nightmechanic/WRFL/power_switch.png

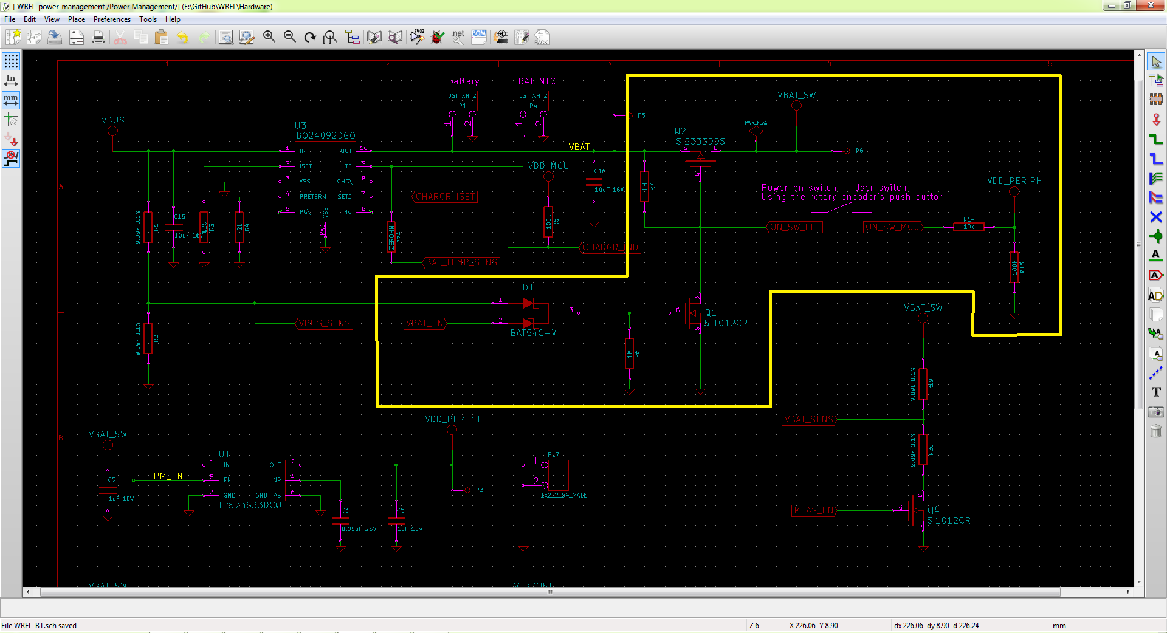
power_switch.png
