nightmechanic/WRFL/Hardware/WRFL_BT.sch

## KiCad design Hardware/WRFL_BT.sch (2014-01-19)

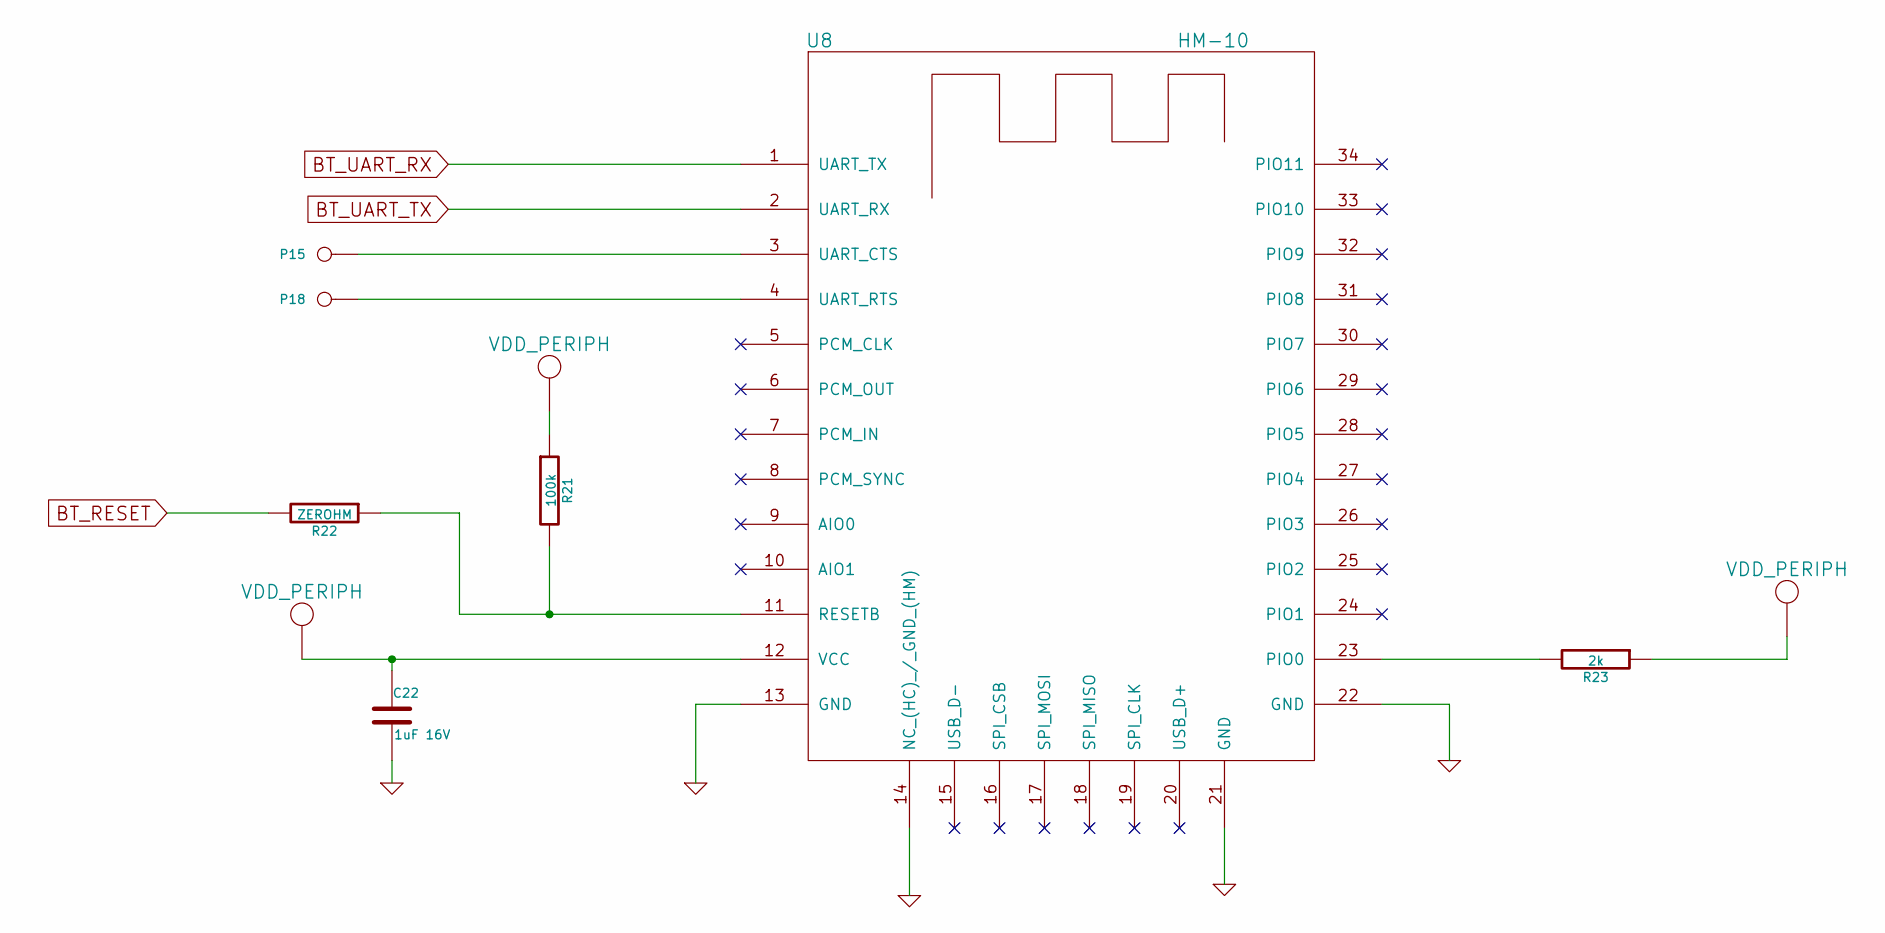
[picture p2: schematic WRFL_BT.sch]

Parts:
C22: 1uF 16V; 0805
P15, P18: TEST_POINT
R21: 100k; 0805
R22: ZEROHM; 0805
R23: 2k; 0805
U8: HM-10

Connections:
BT_RESET: R22.2
BT_UART_RX: U8.1 (UART_TX)
BT_UART_TX: U8.2 (UART_RX)
GND: C22.2, U8.13 (GND), U8.14 (NC_(HC)_/_GND_(HM)), U8.21 (GND), U8.22 (GND)
unnamed: P15.1, U8.3 (UART_CTS)
unnamed: P18.1, U8.4 (UART_RTS)
unnamed: R21.2, R22.1, U8.11 (RESETB)
unnamed: R23.2, U8.23 (PIO0)
VDD_PERIPH: C22.1, R21.1, R23.1, U8.12 (VCC)
