nightmechanic/WRFL/Hardware/WRFL_Launchpad.sch

## KiCad design Hardware/WRFL_Launchpad.sch (2014-01-19)

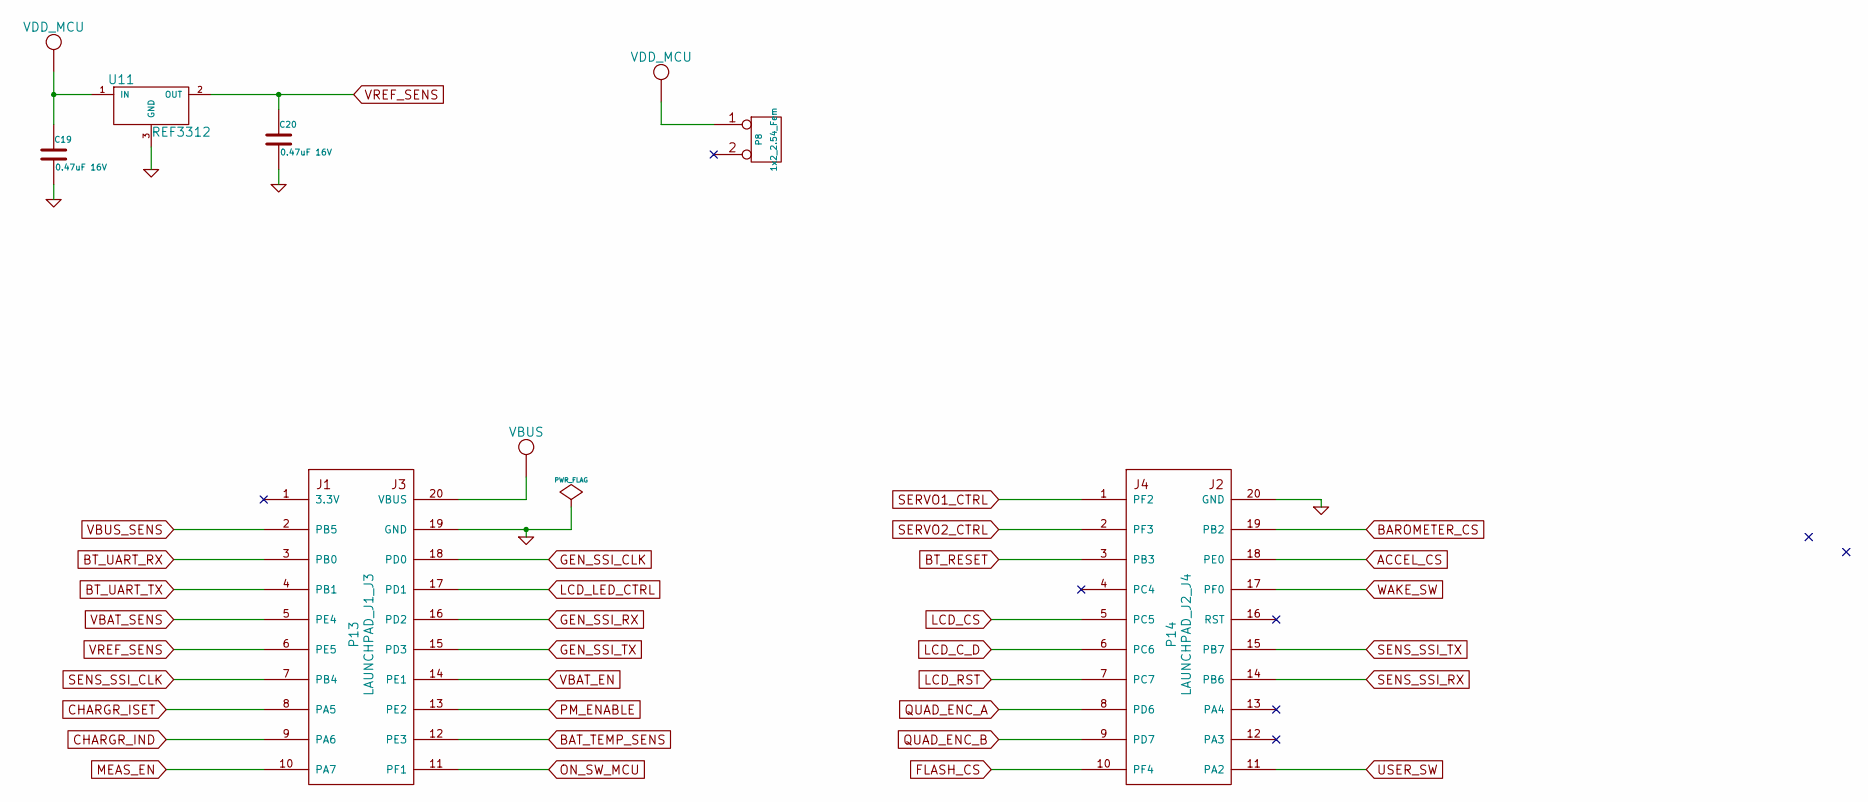
[picture p3: schematic WRFL_Launchpad.sch]

Parts:
C19, C20: 0.47uF 16V; 0805
P8: 1x2_2.54_Fem
P13: LAUNCHPAD_J1_J3
P14: LAUNCHPAD_J2_J4
U11: REF3312

Connections:
ACCEL_CS: P14.18 (PE0)
BAROMETER_CS: P14.19 (PB2)
BAT_TEMP_SENS: P13.12 (PE3)
BT_RESET: P14.3 (PB3)
BT_UART_RX: P13.3 (PB0)
BT_UART_TX: P13.4 (PB1)
CHARGR_IND: P13.9 (PA6)
CHARGR_ISET: P13.8 (PA5)
FLASH_CS: P14.10 (PF4)
GEN_SSI_CLK: P13.18 (PD0)
GEN_SSI_RX: P13.16 (PD2)
GEN_SSI_TX: P13.15 (PD3)
GND: C19.2, C20.2, P13.19 (GND), P14.20 (GND), U11.3 (GND)
LCD_CS: P14.5 (PC5)
LCD_C_D: P14.6 (PC6)
LCD_LED_CTRL: P13.17 (PD1)
LCD_RST: P14.7 (PC7)
MEAS_EN: P13.10 (PA7)
ON_SW_MCU: P13.11 (PF1)
PM_ENABLE: P13.13 (PE2)
QUAD_ENC_A: P14.8 (PD6)
QUAD_ENC_B: P14.9 (PD7)
SENS_SSI_CLK: P13.7 (PB4)
SENS_SSI_RX: P14.14 (PB6)
SENS_SSI_TX: P14.15 (PB7)
SERVO1_CTRL: P14.1 (PF2)
SERVO2_CTRL: P14.2 (PF3)
USER_SW: P14.11 (PA2)
VBAT_EN: P13.14 (PE1)
VBAT_SENS: P13.5 (PE4)
VBUS: P13.20 (VBUS)
VBUS_SENS: P13.2 (PB5)
VDD_MCU: C19.1, P8.1, U11.1 (IN)
VREF_SENS: C20.1, P13.6 (PE5), U11.2 (OUT)
WAKE_SW: P14.17 (PF0)
