nightmechanic/WRFL/Hardware/WRFL_Sensors.sch

## KiCad design Hardware/WRFL_Sensors.sch (2014-01-19)

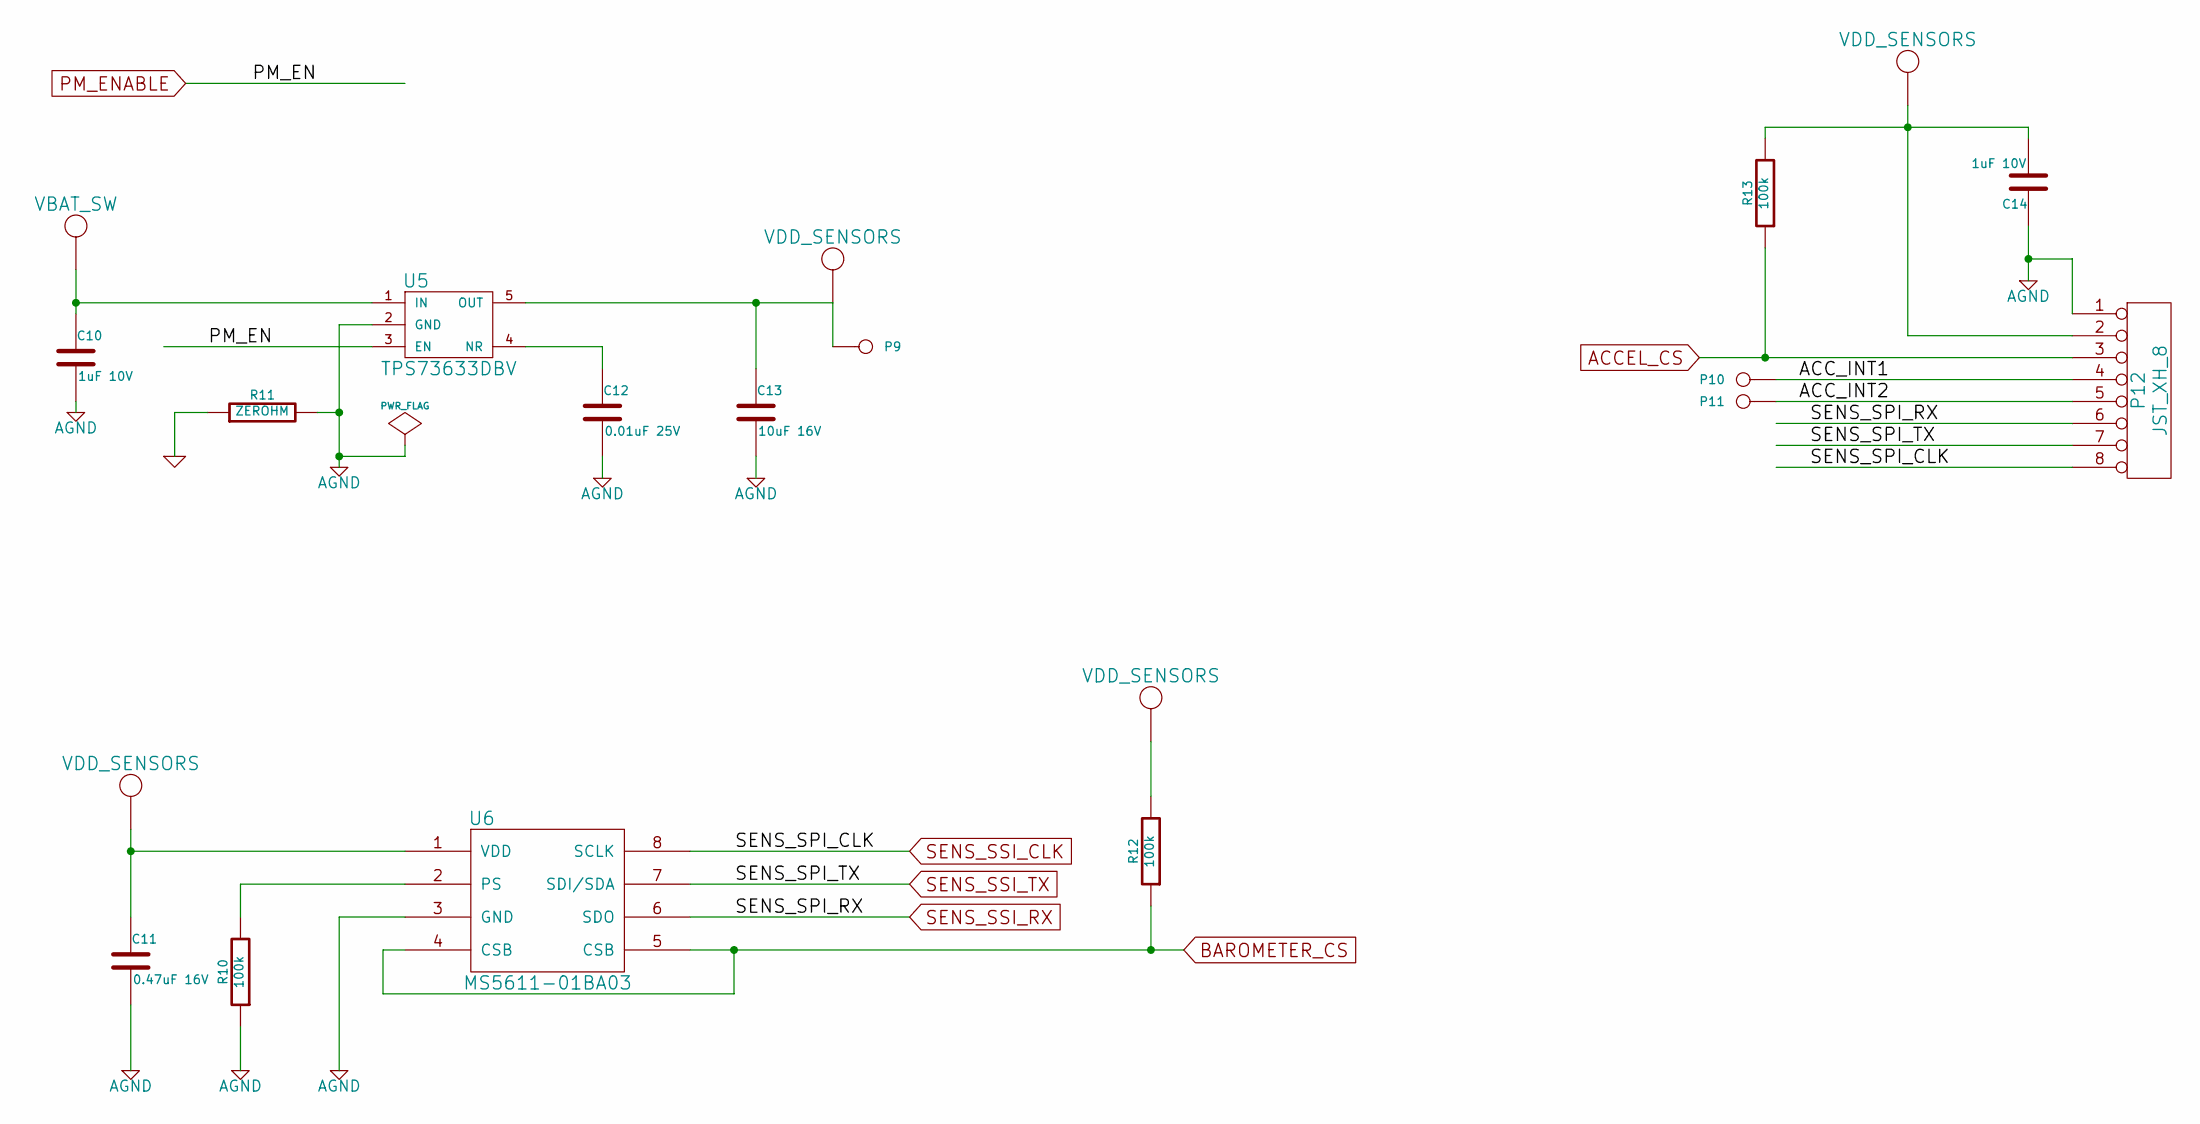
[picture p4: schematic WRFL_Sensors.sch]

Parts:
C10, C14: 1uF 10V; 0805
C11: 0.47uF 16V; 0805
C12: 0.01uF 25V; 0805
C13: 10uF 16V; 0805
P9, P10, P11: TEST_POINT
P12: JST_XH_8
R10, R12, R13: 100k; 0805
R11: ZEROHM; 0805
U5: TPS73633DBV
U6: MS5611-01BA03

Connections:
ACCEL_CS: P12.3, R13.1
ACC_INT1: P10.1, P12.4
ACC_INT2: P11.1, P12.5
AGND: C10.2, C11.2, C12.2, C13.2, C14.1, P12.1, R10.1, R11.2, U5.2 (GND), U6.3 (GND)
BAROMETER_CS: R12.1, U6.4 (CSB), U6.5 (CSB)
GND: R11.1
unnamed: C12.1, U5.4 (NR)
unnamed: R10.2, U6.2 (PS)
PM_ENABLE: U5.3 (EN)
SENS_SSI_CLK: P12.8, U6.8 (SCLK)
SENS_SSI_RX: P12.6, U6.6 (SDO)
SENS_SSI_TX: P12.7, U6.7 (SDI/SDA)
VBAT_SW: C10.1, U5.1 (IN)
VDD_SENSORS: C11.1, C13.1, C14.2, P9.1, P12.2, R12.2, R13.2, U5.5 (OUT), U6.1 (VDD)
