nightmechanic/WRFL/Hardware/WRFL_User_Interface.sch

## KiCad design Hardware/WRFL_User_Interface.sch (2014-01-19)

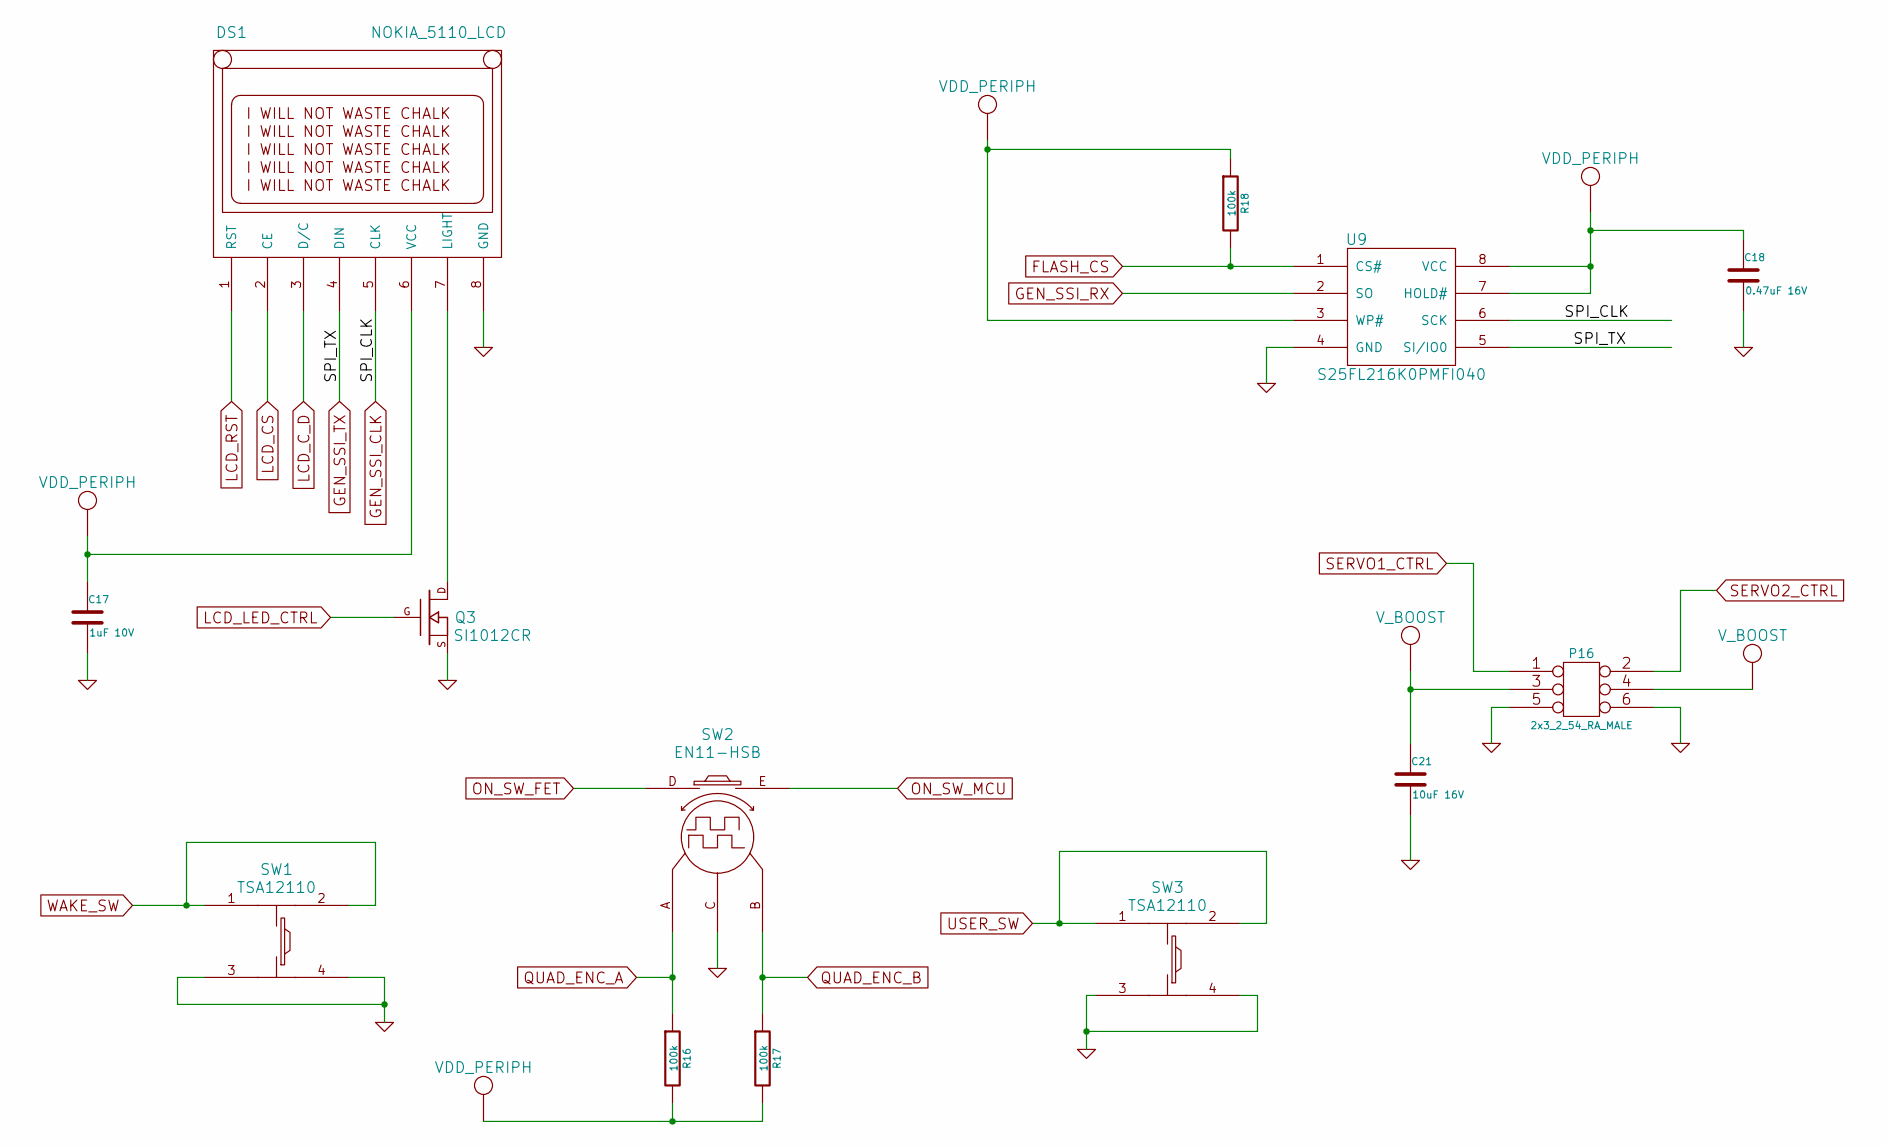
[picture p5: schematic WRFL_User_Interface.sch]

Parts:
C17: 1uF 10V; 0805
C18: 0.47uF 16V; 0805
C21: 10uF 16V; 0805
DS1: NOKIA_5110_LCD
P16: 2x3_2_54_RA_MALE
Q3: SI1012CR; SC-75A
R16, R17, R18: 100k; 0805
SW1, SW3: TSA12110
SW2: EN11-HSB
U9: S25FL216K0PMFI040

Connections:
FLASH_CS: R18.2, U9.1 (CS#)
GEN_SSI_CLK: DS1.5 (CLK), U9.6 (SCK)
GEN_SSI_RX: U9.2 (SO)
GEN_SSI_TX: DS1.4 (DIN), U9.5 (SI/IO0)
GND: C17.2, C18.2, C21.2, DS1.8 (GND), P16.5, P16.6, Q3.S, SW1.3, SW1.4, SW2.C, SW3.3, SW3.4, U9.4 (GND)
LCD_CS: DS1.2 (CE)
LCD_C_D: DS1.3 (D/C)
LCD_LED_CTRL: Q3.G
LCD_RST: DS1.1 (RST)
unnamed: DS1.7 (LIGHT), Q3.D
ON_SW_FET: SW2.D
ON_SW_MCU: SW2.E
QUAD_ENC_A: R16.1, SW2.A
QUAD_ENC_B: R17.1, SW2.B
SERVO1_CTRL: P16.1
SERVO2_CTRL: P16.2
USER_SW: SW3.1, SW3.2
VDD_PERIPH: C17.1, C18.1, DS1.6 (VCC), R16.2, R17.2, R18.1, U9.3 (WP#), U9.7 (HOLD#), U9.8 (VCC)
V_BOOST: C21.1, P16.3, P16.4
WAKE_SW: SW1.1, SW1.2
