nightmechanic/WRFL/Hardware/WRFL_power_management.sch

## KiCad design Hardware/WRFL_power_management.sch (2014-01-19)

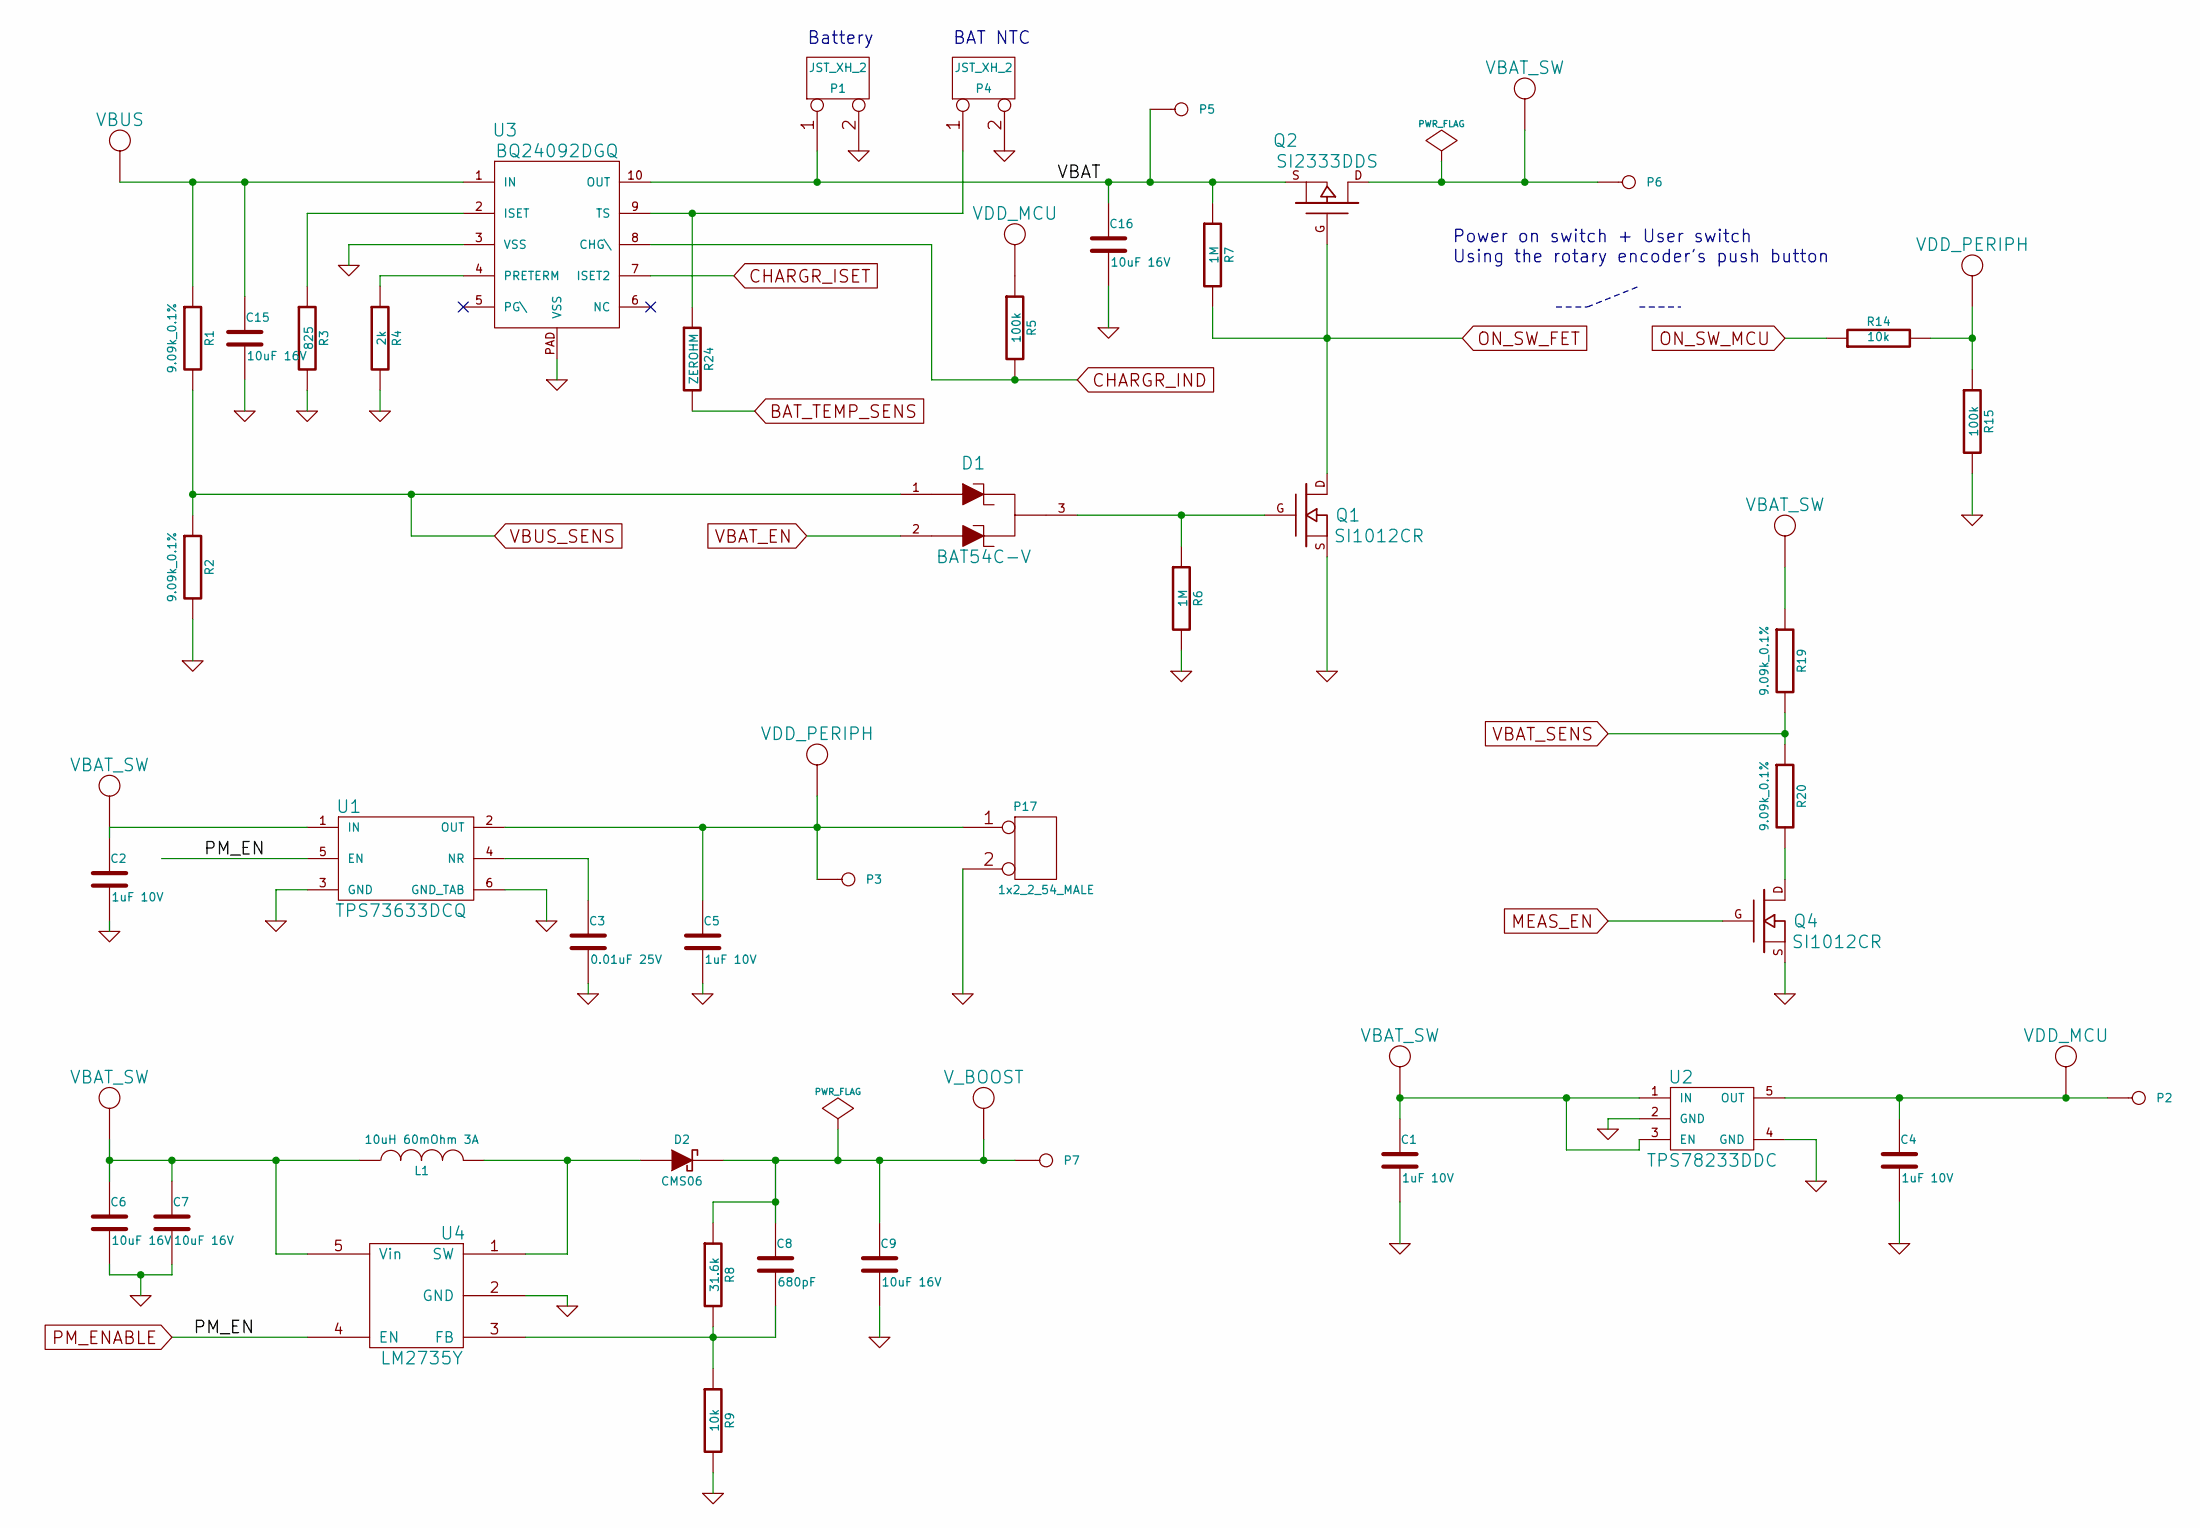
[picture p6: schematic WRFL_power_management.sch]

Parts:
C1, C2, C4, C5: 1uF 10V; 0805
C3: 0.01uF 25V; 0805
C6, C7, C9, C15, C16: 10uF 16V; 0805
C8: 680pF; 0805
D1: BAT54C-V; SOT-23
D2: CMS06
L1: 10uH 60mOhm 3A
P1, P4: JST_XH_2
P2, P3, P5, P6, P7: TEST_POINT
P17: 1x2_2_54_MALE
Q1, Q4: SI1012CR; SC-75A
Q2: SI2333DDS; SOT-23
R1, R2, R19, R20: 9.09k_0.1%; 0805
R3: 825; 0805
R4: 2k; 0805
R5, R15: 100k; 0805
R6, R7: 1M; 0805
R8: 31.6k; 0805
R9, R14: 10k; 0805
R24: ZEROHM; 0805
U1: TPS73633DCQ
U2: TPS78233DDC
U3: BQ24092DGQ
U4: LM2735Y

Connections:
BAT_TEMP_SENS: R24.2
CHARGR_IND: R5.2, U3.8 (CHG\)
CHARGR_ISET: U3.7 (ISET2)
GND: C1.2, C2.2, C3.2, C4.2, C5.2, C6.2, C7.2, C9.2, C15.2, C16.2, P1.2 (PM), P4.2 (PM), P17.2 (PM), Q1.S, Q4.S, R2.2, R3.2, R4.2, R6.2, R9.2, R15.2, U1.3 (GND), U1.6 (GND_TAB), U2.2 (GND), U2.4 (GND), U3.3 (VSS), U3.PAD (VSS), U4.2 (GND)
MEAS_EN: Q4.G
unnamed: C3.1, U1.4 (NR)
unnamed: C8.2, R8.2, R9.1, U4.3 (FB)
unnamed: D1.3 (K), Q1.G, R6.1
unnamed: D2.1 (A), L1.2, U4.1 (SW)
unnamed: P4.1, R24.1, U3.9 (TS)
unnamed: Q4.D, R20.2
unnamed: R3.1, U3.2 (ISET)
unnamed: R4.1, U3.4 (PRETERM)
ON_SW_FET: Q1.D, Q2.G, R7.2
ON_SW_MCU: R14.1
PM_ENABLE: U1.5 (EN), U4.4 (EN)
VBAT: C16.1, P1.1, P5.1, Q2.S, R7.1, U3.10 (OUT)
VBAT_EN: D1.2 (A2)
VBAT_SENS: R19.2, R20.1
VBAT_SW: C1.1, C2.1, C6.1, C7.1, L1.1, P6.1, Q2.D, R19.1, U1.1 (IN), U2.1 (IN), U2.3 (EN), U4.5 (Vin)
VBUS: C15.1, R1.1, U3.1 (IN)
VBUS_SENS: D1.1 (A1), R1.2, R2.1
VDD_MCU: C4.1, P2.1, R5.1, U2.5 (OUT)
VDD_PERIPH: C5.1, P3.1, P17.1, R14.2, R15.1, U1.2 (OUT)
V_BOOST: C8.1, C9.1, D2.2 (K), P7.1, R8.1

Notes on the sheet:
Power on switch + User switch Using the rotary encoder's push button
Battery
BAT NTC
