nightmechanic/WRFL/Firmware/WRFL_Proto/Nokia5110.c

// Nokia5110.c
// Runs on LM4F120
// Use SSI0 to send an 8-bit code to the Nokia5110 48x84
// pixel LCD to display text, images, or other information.
// Daniel Valvano
// June 17, 2013

// Font table, initialization, and other functions based
// off of Nokia_5110_Example from Spark Fun:
// 7-17-2011
// Spark Fun Electronics 2011
// Nathan Seidle
// http://dlnmh9ip6v2uc.cloudfront.net/datasheets/LCD/Monochrome/Nokia_5110_Example.pde

/* This example accompanies the book
   "Embedded Systems: Real Time Interfacing to Arm Cortex M Microcontrollers",
   ISBN: 978-1463590154, Jonathan Valvano, copyright (c) 2013

 Copyright 2013 by Jonathan W. Valvano, valvano@mail.utexas.edu
    You may use, edit, run or distribute this file
    as long as the above copyright notice remains
 THIS SOFTWARE IS PROVIDED "AS IS".  NO WARRANTIES, WHETHER EXPRESS, IMPLIED
 OR STATUTORY, INCLUDING, BUT NOT LIMITED TO, IMPLIED WARRANTIES OF
 MERCHANTABILITY AND FITNESS FOR A PARTICULAR PURPOSE APPLY TO THIS SOFTWARE.
 VALVANO SHALL NOT, IN ANY CIRCUMSTANCES, BE LIABLE FOR SPECIAL, INCIDENTAL,
 OR CONSEQUENTIAL DAMAGES, FOR ANY REASON WHATSOEVER.
 For more information about my classes, my research, and my books, see
 http://users.ece.utexas.edu/~valvano/
 */

/* Modified by Ran Katz (Nightmechanic) for the WRFL project
 * modified to use standard TI Tivaware peripheral drivers (in ROM if available)
 */

// Signal        (Nokia 5110) LM4F120 pin
// Reset         (RST, pin 1) connected to PA7
// SSI0Fss       (CE,  pin 2) connected to PA3
// Data/Command  (DC,  pin 3) connected to PA6
// SSI0Tx        (Din, pin 4) connected to PA5
// SSI0Clk       (Clk, pin 5) connected to PA2
// 3.3V          (Vcc, pin 6) power
// not connected (BL,  pin 7) back light
// Ground        (Gnd, pin 8)


#include "Nokia5110.h"
#include "platform.h"

#include <stdbool.h>
#include <stdint.h>

#include "inc/hw_types.h"
#include "driverlib/ssi.h"
#include "driverlib/gpio.h"
#include "driverlib/sysctl.h"
#include "driverlib/rom.h"
#include "driverlib/rom_map.h"

#define RESET(value)			(GPIOPinWrite(LCD_RESET_PORT, LCD_RESET_PIN,  value))
#define RESET_LOW               0
#define RESET_HIGH              LCD_RESET_PIN
#define DC(value)				(GPIOPinWrite(LCD_DC_PORT, LCD_DC_PIN, value))
#define DC_COMMAND              0
#define DC_DATA                 LCD_DC_PIN
#define DC_VALUE				(GPIOPinRead(LCD_DC_PORT, LCD_DC_PIN))


enum typeOfWrite{
  COMMAND,                              // the transmission is an LCD command
  DATA                                  // the transmission is data
};
// This is a helper function that sends an 8-bit message to the LCD.
// inputs: type  COMMAND or DATA
//         data  8-bit data to transmit
// outputs: none
// assumes: SSI0 and port A have already been initialized
static void lcdwrite(enum typeOfWrite type, char data){
	//unsigned int dummy;
	int new_DC;


	if(type == COMMAND){
		new_DC=DC_COMMAND;
	} else{
		new_DC=DC_DATA;
	}

	//check if the DC line needs to change - if so we must do that after the
	if (new_DC != DC_VALUE){
		//wait for SPI to finish
		while(MAP_SSIBusy(LCD_SSI_BASE));
	}

	DC(new_DC);

  MAP_SSIDataPut(LCD_SSI_BASE, data);


}

//********Nokia5110_Init*****************
// Initialize Nokia 5110 48x84 LCD by sending the proper
// commands to the PCD8544 driver.  One new feature of the
// LM4F120 is that its SSIs can get their baud clock from
// either the system clock or from the 16 MHz precision
// internal oscillator.  If the system clock is faster than
// 50 MHz, the SSI baud clock will be faster than the 4 MHz
// maximum of the Nokia 5110.
// inputs: none
// outputs: none
// assumes: system clock rate of 50 MHz or less
void Nokia5110_Init(void){
  volatile unsigned long delay;


  //disable SSI
  MAP_SSIDisable(LCD_SSI_BASE);
  //set clock and other parameters
  MAP_SSIConfigSetExpClk(LCD_SSI_BASE, SysCtlClockGet(), SSI_FRF_MOTO_MODE_0,
                         SSI_MODE_MASTER, 3000000, 8);
  //enable SSI
  MAP_SSIEnable(LCD_SSI_BASE);

  RESET(RESET_LOW);                    // reset the LCD to a known state
  for(delay=0; delay<10; delay=delay+1);// delay minimum 100 ns
  RESET(RESET_HIGH);                   // negative logic

  lcdwrite(COMMAND, 0x21);              // chip active; horizontal addressing mode (V = 0); use extended instruction set (H = 1)
  lcdwrite(COMMAND, 0xb8);              // set LCD Vop (contrast): try 0xB1 (good @ 3.3V) or 0xBF if your display is too dark
  lcdwrite(COMMAND, 0x04);              // set temp coefficient
  lcdwrite(COMMAND, 0x14);              // LCD bias mode 1:48: try 0x13 or 0x14

  lcdwrite(COMMAND, 0x20);              // we must send 0x20 before modifying the display control mode
  lcdwrite(COMMAND, 0x0c);              // set display control to normal mode: 0x0D for inverse
}

//********Nokia5110_OutChar*****************
// Print a character to the Nokia 5110 48x84 LCD.  The
// character will be printed at the current cursor position,
// the cursor will automatically be updated, and it will
// wrap to the next row or back to the top if necessary.
// One blank column of pixels will be printed on either side
// of the character for readability.  Since characters are 8
// pixels tall and 5 pixels wide, 12 characters fit per row,
// and there are six rows.
// inputs: data  character to print
// outputs: none
// assumes: LCD is in default horizontal addressing mode (V = 0)
void Nokia5110_OutChar(unsigned char data){
  int i;
  lcdwrite(DATA, 0x00);                 // blank vertical line padding
  for(i=0; i<5; i=i+1){
    lcdwrite(DATA, ASCII[data - 0x20][i]);
  }
  lcdwrite(DATA, 0x00);                 // blank vertical line padding
}

//********Nokia5110_OutString*****************
// Print a string of characters to the Nokia 5110 48x84 LCD.
// The string will automatically wrap, so padding spaces may
// be needed to make the output look optimal.
// inputs: ptr  pointer to NULL-terminated ASCII string
// outputs: none
// assumes: LCD is in default horizontal addressing mode (V = 0)
void Nokia5110_OutString(char *ptr){
  while(*ptr){
    Nokia5110_OutChar((unsigned char)*ptr);
    ptr = ptr + 1;
  }
}

//********Nokia5110_OutUDec*****************
// Output a 16-bit number in unsigned decimal format with a
// fixed size of five right-justified digits of output.
// Inputs: n  16-bit unsigned number
// Outputs: none
// assumes: LCD is in default horizontal addressing mode (V = 0)
void Nokia5110_OutUDec(unsigned short n){
  if(n < 10){
    Nokia5110_OutString("    ");
    Nokia5110_OutChar(n+'0'); /* n is between 0 and 9 */
  } else if(n<100){
    Nokia5110_OutString("   ");
    Nokia5110_OutChar(n/10+'0'); /* tens digit */
    Nokia5110_OutChar(n%10+'0'); /* ones digit */
  } else if(n<1000){
    Nokia5110_OutString("  ");
    Nokia5110_OutChar(n/100+'0'); /* hundreds digit */
    n = n%100;
    Nokia5110_OutChar(n/10+'0'); /* tens digit */
    Nokia5110_OutChar(n%10+'0'); /* ones digit */
  }
  else if(n<10000){
    Nokia5110_OutChar(' ');
    Nokia5110_OutChar(n/1000+'0'); /* thousands digit */
    n = n%1000;
    Nokia5110_OutChar(n/100+'0'); /* hundreds digit */
    n = n%100;
    Nokia5110_OutChar(n/10+'0'); /* tens digit */
    Nokia5110_OutChar(n%10+'0'); /* ones digit */
  }
  else {
    Nokia5110_OutChar(n/10000+'0'); /* ten-thousands digit */
    n = n%10000;
    Nokia5110_OutChar(n/1000+'0'); /* thousands digit */
    n = n%1000;
    Nokia5110_OutChar(n/100+'0'); /* hundreds digit */
    n = n%100;
    Nokia5110_OutChar(n/10+'0'); /* tens digit */
    Nokia5110_OutChar(n%10+'0'); /* ones digit */
  }
}

//********Nokia5110_SetCursor*****************
// Move the cursor to the desired X- and Y-position.  The
// next character will be printed here.  X=0 is the leftmost
// column.  Y=0 is the top row.
// inputs: newX  new X-position of the cursor (0<=newX<=11)
//         newY  new Y-position of the cursor (0<=newY<=5)
// outputs: none
void Nokia5110_SetCursor(unsigned char newX, unsigned char newY){
  if((newX > 11) || (newY > 5)){        // bad input
    return;                             // do nothing
  }
  // multiply newX by 7 because each character is 7 columns wide
  lcdwrite(COMMAND, 0x80|(newX*7));     // setting bit 7 updates X-position
  lcdwrite(COMMAND, 0x40|newY);         // setting bit 6 updates Y-position
}

//********Nokia5110_Clear*****************
// Clear the LCD by writing zeros to the entire screen and
// reset the cursor to (0,0) (top left corner of screen).
// inputs: none
// outputs: none
void Nokia5110_Clear(void){
  int i;
  for(i=0; i<(MAX_X*MAX_Y/8); i=i+1){
    lcdwrite(DATA, 0x00);
  }
  Nokia5110_SetCursor(0, 0);
}

//********Nokia5110_DrawFullImage*****************
// Fill the whole screen by drawing a 48x84 bitmap image.
// inputs: ptr  pointer to 504 byte bitmap
// outputs: none
// assumes: LCD is in default horizontal addressing mode (V = 0)
void Nokia5110_DrawFullImage(const char *ptr){
  int i;
  Nokia5110_SetCursor(0, 0);
  for(i=0; i<(MAX_X*MAX_Y/8); i=i+1){
    lcdwrite(DATA, ptr[i]);
  }
}

void Nokia5110_OutUDec_NoSpace(unsigned short n){
  if(n < 10){
    //Nokia5110_OutString("    ");
    Nokia5110_OutChar(n+'0'); /* n is between 0 and 9 */
  } else if(n<100){
    //Nokia5110_OutString("   ");
    Nokia5110_OutChar(n/10+'0'); /* tens digit */
    Nokia5110_OutChar(n%10+'0'); /* ones digit */
  } else if(n<1000){
    //Nokia5110_OutString("  ");
    Nokia5110_OutChar(n/100+'0'); /* hundreds digit */
    n = n%100;
    Nokia5110_OutChar(n/10+'0'); /* tens digit */
    Nokia5110_OutChar(n%10+'0'); /* ones digit */
  }
  else if(n<10000){
    //Nokia5110_OutChar(' ');
    Nokia5110_OutChar(n/1000+'0'); /* thousands digit */
    n = n%1000;
    Nokia5110_OutChar(n/100+'0'); /* hundreds digit */
    n = n%100;
    Nokia5110_OutChar(n/10+'0'); /* tens digit */
    Nokia5110_OutChar(n%10+'0'); /* ones digit */
  }
  else {
    Nokia5110_OutChar(n/10000+'0'); /* ten-thousands digit */
    n = n%10000;
    Nokia5110_OutChar(n/1000+'0'); /* thousands digit */
    n = n%1000;
    Nokia5110_OutChar(n/100+'0'); /* hundreds digit */
    n = n%100;
    Nokia5110_OutChar(n/10+'0'); /* tens digit */
    Nokia5110_OutChar(n%10+'0'); /* ones digit */
  }
}

void Nokia5110_OutFloatp3(float fnum){

	int32_t i32IntegerPart;
	int32_t i32FractionPart;
	 // Convert the floats to an integer part and fraction part for easy
	 // print.
	//
	i32IntegerPart = (int32_t) fnum;
	i32FractionPart =(int32_t) (fnum * 1000.0f);
	i32FractionPart = i32FractionPart - (i32IntegerPart * 1000);
	if(i32FractionPart < 0)
	{
	   i32FractionPart *= -1;
	}

	 if(i32IntegerPart<0)
	 {
		 Nokia5110_OutString("-");
		 i32IntegerPart *= -1;
	 }

	 //print integer part
	 Nokia5110_OutUDec_NoSpace((unsigned short)i32IntegerPart);

	 //decimal ppoint
	 Nokia5110_OutString(".");

	 //fractional part
	 //leading zeroes if needed
	 if(i32FractionPart<10)
		 Nokia5110_OutChar('0');
	 if(i32FractionPart<100)
		 Nokia5110_OutChar('0');

	Nokia5110_OutUDec_NoSpace((unsigned short)i32FractionPart);

}
