nightmechanic/WRFL/Firmware/WRFL_Proto/wrfl_proto_mux.c

//*****************************************************************************
// Copyright (c) 2013 Texas Instruments Incorporated.  All rights reserved.
// Software License Agreement
// 
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
//   Redistributions of source code must retain the above copyright
//   notice, this list of conditions and the following disclaimer.
// 
//   Redistributions in binary form must reproduce the above copyright
//   notice, this list of conditions and the following disclaimer in the
//   documentation and/or other materials provided with the  
//   distribution.
// 
//   Neither the name of Texas Instruments Incorporated nor the names of
//   its contributors may be used to endorse or promote products derived
//   from this software without specific prior written permission.
// 
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
// This file was automatically generated by the Tiva C Series PinMux Utility
// Version: 1.0.2
//
//*****************************************************************************

#include <stdbool.h>
#include <stdint.h>
#include "wrfl_proto_mux.h"
#include "inc/hw_types.h"
#include "inc/hw_memmap.h"
#include "inc/hw_gpio.h"
#include "driverlib/sysctl.h"
#include "driverlib/pin_map.h"
#include "driverlib/rom_map.h"
#include "driverlib/gpio.h"

//*****************************************************************************
void
PortFunctionInit(void)
{
    //
    // Enable Peripheral Clocks 
    //
    MAP_SysCtlPeripheralEnable(SYSCTL_PERIPH_I2C1);
    MAP_SysCtlPeripheralEnable(SYSCTL_PERIPH_SSI2);
    MAP_SysCtlPeripheralEnable(SYSCTL_PERIPH_GPIOA);
    MAP_SysCtlPeripheralEnable(SYSCTL_PERIPH_GPIOB);
    MAP_SysCtlPeripheralEnable(SYSCTL_PERIPH_GPIOF);

    //
    // Enable port PB0 for GPIOOutput
    //
    MAP_GPIOPinTypeGPIOOutput(GPIO_PORTB_BASE, GPIO_PIN_0);

    //
    // Enable port PB1 for GPIOOutput
    //
    MAP_GPIOPinTypeGPIOOutput(GPIO_PORTB_BASE, GPIO_PIN_1);

    //
    // Enable port PF0 for GPIOInput
    //

    //
    //First open the lock and select the bits we want to modify in the GPIO commit register.
    //
    HWREG(GPIO_PORTF_BASE + GPIO_O_LOCK) = GPIO_LOCK_KEY;
    HWREG(GPIO_PORTF_BASE + GPIO_O_CR) = 0x1;

    //
    //Now modify the configuration of the pins that we unlocked.
    //
    MAP_GPIOPinTypeGPIOInput(GPIO_PORTF_BASE, GPIO_PIN_0);

    //
    // Enable port PF4 for GPIOInput
    //
    MAP_GPIOPinTypeGPIOInput(GPIO_PORTF_BASE, GPIO_PIN_4);

    //
    // Enable port PA7 for I2C1 I2C1SDA
    //
    MAP_GPIOPinConfigure(GPIO_PA7_I2C1SDA);
    MAP_GPIOPinTypeI2C(GPIO_PORTA_BASE, GPIO_PIN_7);

    //
    // Enable port PA6 for I2C1 I2C1SCL
    //
    MAP_GPIOPinConfigure(GPIO_PA6_I2C1SCL);
    MAP_GPIOPinTypeI2CSCL(GPIO_PORTA_BASE, GPIO_PIN_6);

    //
    // Enable port PB4 for SSI2 SSI2CLK
    //
    MAP_GPIOPinConfigure(GPIO_PB4_SSI2CLK);
    MAP_GPIOPinTypeSSI(GPIO_PORTB_BASE, GPIO_PIN_4);

    //
    // Enable port PB5 for SSI2 SSI2FSS
    //
    MAP_GPIOPinConfigure(GPIO_PB5_SSI2FSS);
    MAP_GPIOPinTypeSSI(GPIO_PORTB_BASE, GPIO_PIN_5);

    //
    // Enable port PB7 for SSI2 SSI2TX
    //
    MAP_GPIOPinConfigure(GPIO_PB7_SSI2TX);
    MAP_GPIOPinTypeSSI(GPIO_PORTB_BASE, GPIO_PIN_7);
}
