nightmechanic/WRFL/(commit log)

2013-10-02 First attempt
    non complete draft schematics
    [WRFL.sch, WRFL_Launchpad.sch, WRFL_Sensors.sch, WRFL_User_Interface.sch, WRFL_power_management.sch]
2013-10-03 moved sensor LDO
    to sensor sheet
    [WRFL.sch, WRFL_Launchpad.sch, WRFL_Sensors.sch, WRFL_User_Interface.sch, WRFL_power_management.sch]
2013-10-06 PM, UI and sensor sheets almost done
    [WRFL.csv]
2013-10-07 Added VREF and 2x3 for servos
    [WRFL.sch, WRFL_Launchpad.sch, WRFL_Sensors.sch, WRFL_User_Interface.sch, WRFL_power_management.sch]
2013-10-07 Added VBAT sens
    [WRFL.csv, WRFL.sch, WRFL_Launchpad.sch, WRFL_Sensors.sch, WRFL_User_Interface.sch, WRFL_power_management.sch]
2013-10-07 added footprint values for caps and resistors
    [WRFL.csv, WRFL.sch, WRFL.xlsx, WRFL_Launchpad.sch, WRFL_Sensors.sch, WRFL_User_Interface.sch, WRFL_power_management.sch]
2013-10-10 Schematics update
    Bluetooth sheet added
    LCD specific symbol
    power management sheet rearrangement
    [WRFL.csv, WRFL.sch, WRFL_BT.sch, WRFL_Launchpad.sch, WRFL_Sensors.sch, WRFL_User_Interface.sch, WRFL_power_management.sch, WRFL_sourcing.csv]
2013-10-15 more changes
    Changed BAS40 to BAT54C
    [WRFL.csv, WRFL.sch, WRFL_BT.sch, WRFL_Launchpad.sch, WRFL_Sensors.sch, WRFL_User_Interface.sch, WRFL_power_management.sch]
2013-10-22 MCU function assignment
    BT RTS/CTS as test points,
    BT reset GPIO option
    Launchpad header pin function assignment (for ERC check)
    Power symbols corrections
    [WRFL.sch, WRFL_BT.sch, WRFL_Launchpad.sch, WRFL_Sensors.sch, WRFL_User_Interface.sch, WRFL_pin_mux.xlsx, WRFL_power_management.sch]
2013-10-27 Added BAT temp sens
    [WRFL.sch, WRFL_BT.sch, WRFL_Launchpad.sch, WRFL_Sensors.sch, WRFL_User_Interface.sch, WRFL_pin_mux.xlsx, WRFL_power_management.sch]
2013-10-27 pin mux table format
    [WRFL_pin_mux.xlsx]
2013-10-31 on switch pull supply correction
    [WRFL.sch, WRFL_BT.sch, WRFL_Launchpad.sch, WRFL_Sensors.sch, WRFL_User_Interface.sch, WRFL_power_management.sch]
2013-11-28 Prototype FW Ver 0
    Display and BMP180 working
    To Do:
    1. Altitude Kalman filter
    2. Relative altitude (+zeroing)
    3. Apogee detection
    4. Servo control
2013-12-04 Display + altitude Kalman filter
    todo:
    1. apogee detection
    2. PWM for servo
    3. relative altitude
2013-12-05 updated LCD driver
    OutFloatp3 added
2014-01-19 3d Kalman filter progress + minor sch
    -moving towards a matrix (CMSIS) based kalman implementation
    -cosmetic schematic changes
    [WRFL.sch, WRFL_BT.sch, WRFL_Launchpad.sch, WRFL_Sensors.sch, WRFL_User_Interface.sch, WRFL_power_management.sch]
2014-02-11 Kalman filter updates
    finished (?) MD_kalman implementation
